gavinlyonsrepo/LCR_meter/(threads)

Thread 1 (2021-04-22):

What is the voltage Range of 2 Uf Capacitor?

rupeshdudakiya, 2021-04-22:

gavinlyonsrepo, 2021-04-22:
Hi

The circuit is limited at 5V vcc so anything above 7 v should be good.
Make sure to use Use  non-polarized .

I used 2 *  1uF 50V Monolithic Ceramic Chip Capacitor in parallel when i tested.

kenta2412, 2021-04-24:
thank you!

Vào 24-04-2021 7:51, "Gavin Lyons" ***@***.***> đã viết:

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

Closed 2021-04-24.

Thread 3 (2023-05-20):

D11 not set

thuckabee, 2023-05-20:
the D11 pin is never set to input with pull up resistor.
I set it a input pin in setup!

gavinlyonsrepo, 2023-05-20:
hi

D11 (& D12) are Push button inputs, They are setup in the "init" method of the push button library
which is included in the code folder.

thuckabee, 2023-05-20:
try and run the code d11 is not set in the ver of code a got

    On Saturday, May 20, 2023 at 02:51:57 PM EDT, Gavin Lyons ***@***.***> wrote:

hi

D11 (& D12) are Push button inputs, They are setup in the "init" method of the push button library
which is included in the code folder.

—
Reply to this email directly, view it on GitHub, or unsubscribe.
You are receiving this because you authored the thread.Message ID: ***@***.***>
